hmojicag/public-glucometro-infrarrojo/SourceV0.3/BasicGlucoTester-CS-VisualStudioProject/BasicGlucoTester/Resources/gota.png

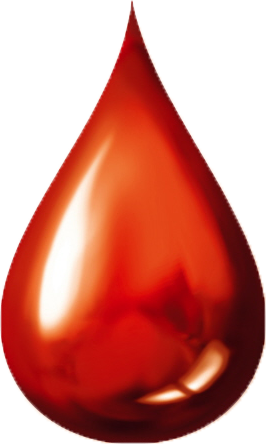
SourceV0.3/BasicGlucoTester-CS-VisualStudioProject/BasicGlucoTester/Resources/gota.png
