hmojicag/public-glucometro-infrarrojo/README.md

# public-glucometro-infrarrojo
Codigo, banners y documentos del glucometro infrarrojo
