hmojicag/public-glucometro-infrarrojo/Glucometro_Infrarrojo.pdf

## Glucometro Infrarrojo

Hazael F. Mojica G. y Ricardo I. Guevara Z.

Lunes 2 de Diciembre del 2013

Hazael Fernando Mojica Garcia Ricardo Israel Guevara Zavala Medidor de glucosa por Infrarrojos

## 1. INTRODUCCION´

Existen muchas personas en el mundo y en especial en Mexico con problemas para con- ´ trolar su nivel de glucosa en la sangre. Padecimientos tales como la diabetes afectan alrededor
de 10 millones de personas en tan solo en M ´ | exico y 13 de cada 100 muertes en este pa ´ | ´ıs son
a causa de la diabetes.
El proyecto que proponemos es una manera de detectar niveles anormales de glucosa en la sangre por medio de dispositivos sencillos, rapidos y eficientes tales como los sensores de ´ infrarrojo.
La glucosa muestra una alta absorbancia a la luz infrarroja, por lo tanto es posible desarro-
llar un dispositivo electronico que sea portatil, r ´ | apido, econ ´ | omico y fiable capaz de detectar ´
dicha absorbancia en una muestra de sangre, analizarla y arrojar la cantidad de glucosa con-tenida en la misma.
La glucosa existente en la sangre, como toda sustancia, posee niveles de absorbancia (cantidad de luz que dicha sustancia absorbe, la cual es transformada en otra forma de energ´ıa). La glucosa posee la particularidad de tener un gran valor de absorbancia para la luz infrarroja (940 nm de longitud de onda). Basandonos en dicho principio, nosotros hemos desarrollado ´ un dispositivo capaz de medir dicha absorbancia por medio de dispositivos electronicos de ´ uso comercial.
Por medio de un arreglo de leds que emiten en el infrarrojo, un arreglo de transistores capaz de detectar los fotones emitidos a la longitud de onda correcta (o mejor dicho, la varia-
cion de dicha intensidad) y una sistema de adquisici ´ | on de datos el cual utiliza un procesador ´
Arduino. Con base en dichos elementos y aunado a un software desarrollado exprofeso para esta aplicacion, hemos logrado crear un dispositivo capaz de detectar con nivel de exactitud ´ aceptable, la absorbancia de varias muestras que poseen una solucion con diferentes niveles ´ de glucosa diluidas en las mismas.
Como resultado, hemos desarrollado un sistema para analisis de glucosa de forma port ´ | atil, ´
eficiente y economica. ´
| 1

1.1 Espectro de Absorcion de la sangre | 1 INTRODUCCI ´ | ON´

### 1.1. Espectro de Absorcion de la sangre ´

La sangre y en especial la glucosa poseen espectros de absorcion con valores altos para ´ longitudes de onda que entran en el rango del infrarrojo. Esto beneficia a nuestra investigacion´ porque si la sangre a analizar absorbe mayor radiacion infrarroja quiere decir que tendremos ´
una mayor variacion por cada diferencia de concentraci ´ | on de glucosa en la sangre a analizar. ´

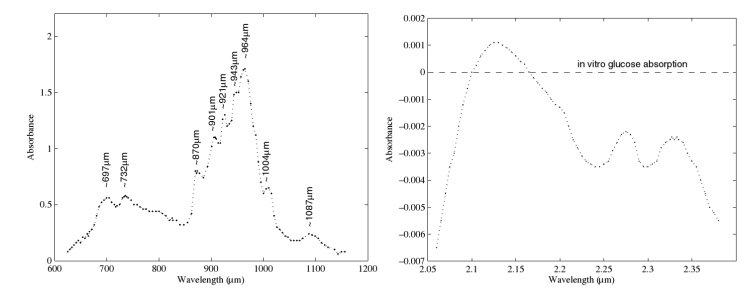
[picture p10: figure]

Figura 1 La imagen muestra el espectro de absrocion de la Glucosa. Esta imagen es propiedad ´ intelectual de Frederick Chee y Tyrone Fernando?

En la imagen Fig.?? podemos ver el espectro de absorcion de la glucosa y claramente ´ se observa que el espectro de absorcion para valores de longitudes de onda en rangos del ´ infrarrojo (en especial entre 900 y 1000 nm) poseen una Absorbancia muy elevada.

La medicion de la cantidad de glucosa en la sangre es una pr ´ | actica com ´ | un en la actua- ´
lidad, y en la mayor´ıa de los casos conocidos se necesita siempre una muestra de sangre a analizar, para los fines de este proyecto nosotros tambien analizaremos una muestra de sangre ´ pero en lugar de aplicar un voltaje y medir la corriente a traves de dicha muestra lo que hare- ´
mos sera irradiar dicha muestra con luz infrarroja (940nm de longitud de onda seg ´ | un nuestro ´
emisor LED IR333 Fig.?? y Fig.??) y recibiremos por medio de un receptor (foto transistor
IR PT1302B/C2 ) la senal atenuada despu ˜ | es de atravesar la muestra. ´

2

1 INTRODUCCION | 1.1 Espectro de Absorci ´ | on de la sangre ´

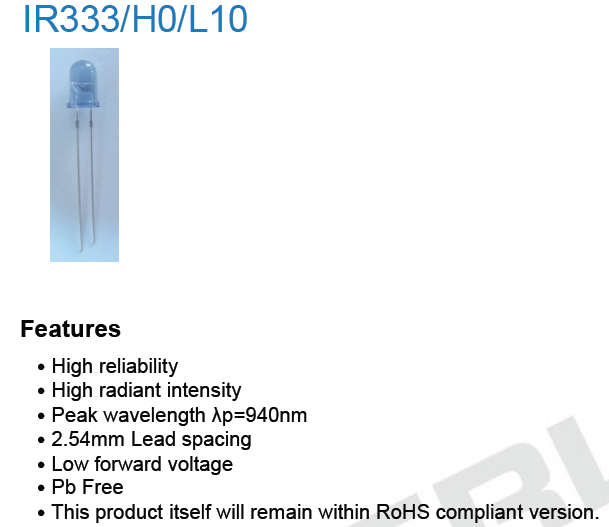
[picture p11: figure]

Figura 2 Caracter´ısticas principales del emisor IR usado

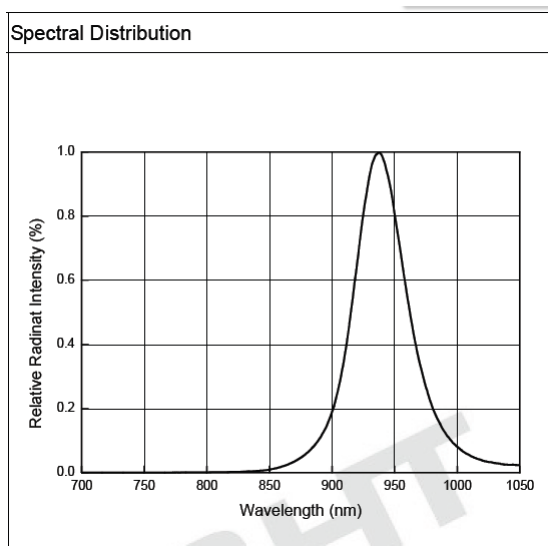
[picture p12: figure]

Figura 3 Curva de la Intensidad de Radiacion Relativa contra la longitud de onda. Se observa que las ´ emisiones de luz de 940nm son las mas intensas ´

La diferencia entre la senal emitida y la se ˜ | nal recibida ser ˜ | a medida y comparada en dife- ´
rentes muestras de sangre, y asi poder discernir entre las muestras que puedan ser consideradas con niveles de glucosa normales y aquellas que posean niveles de glucosa anormales.
| 3

2 ESQUEMATICOS DEL SISTEMA FINAL ´

Sin duda alguna no obtendremos un espectro completo de las longitudes de onda que absorbe la muestra de sangre ya que solo la irradiaremos con longitudes de onda pertene-cientes a los infrarrojos (en especial la de 940nm), pero realizaremos pruebas para saber si es suficiente con esta longitud de onda para obtener resultados concluyentes.
Se usara un Arduino para la obtenci ´ | on de los datos y posiblemente para el despliegue de ´
los resultados por medio de una pantalla LCD, este tendra tambi ´ | en conexi ´ | on a la computadora ´
por medio de USB (emulacion de puerto serie UART) para simplificar la calibraci ´ | on. ´
Se planea hacer una shield para Arduino en donde se puedan conectar todos los dispositivos.

## 2. Esquematicos del sistema final ´

Debido al bajo presupuesto se acordo que solo se dejaran dos tarjetas, las cuales son las ´ m´ınimas necesarias para que el proyecto funcione de la mejor manera posible.
La Tarjeta shield (en la cual se enbebio la tarjeta LCD y la Tarjeta de los push-buttons) y ´ la Tarjeta IR. (Se decidio no embeber la tarjeta IR dentro de la shield debido a los soportes ´ hechos en acr´ılico que sobrepasan el tamano del shield mismo). ˜

4

2 ESQUEMATICOS DEL SISTEMA FINAL2.1 Esquem ´ | aticos y Dise ´ | no electr ˜ | onico: Tarjeta Shield Final ´
2.1. Esquematicos y Dise ´ | no electr ˜ | onico: Tarjeta Shield Final ´

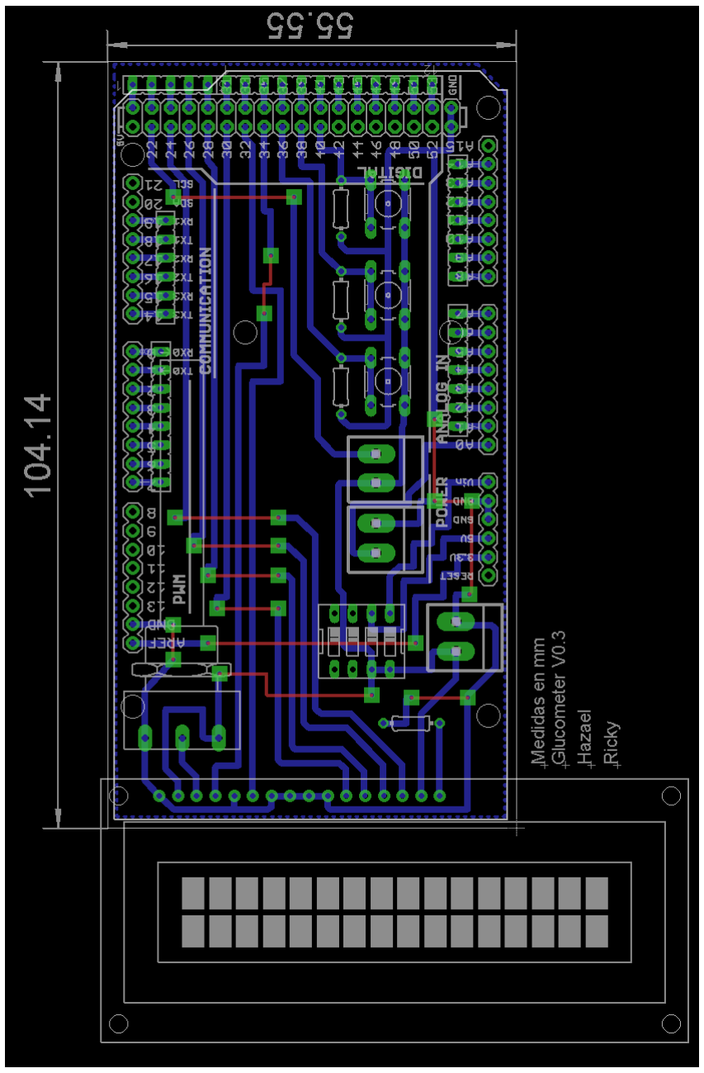
[picture p13: figure]

Figura 4 Diseno electr ˜ | onico de la tarjeta shield ´

5

2.1 Esquematicos y Dise ´ | no electr ˜ | onico: Tarjeta Shield Final2 ESQUEM ´ | ATICOS DEL SISTEMA FINAL ´

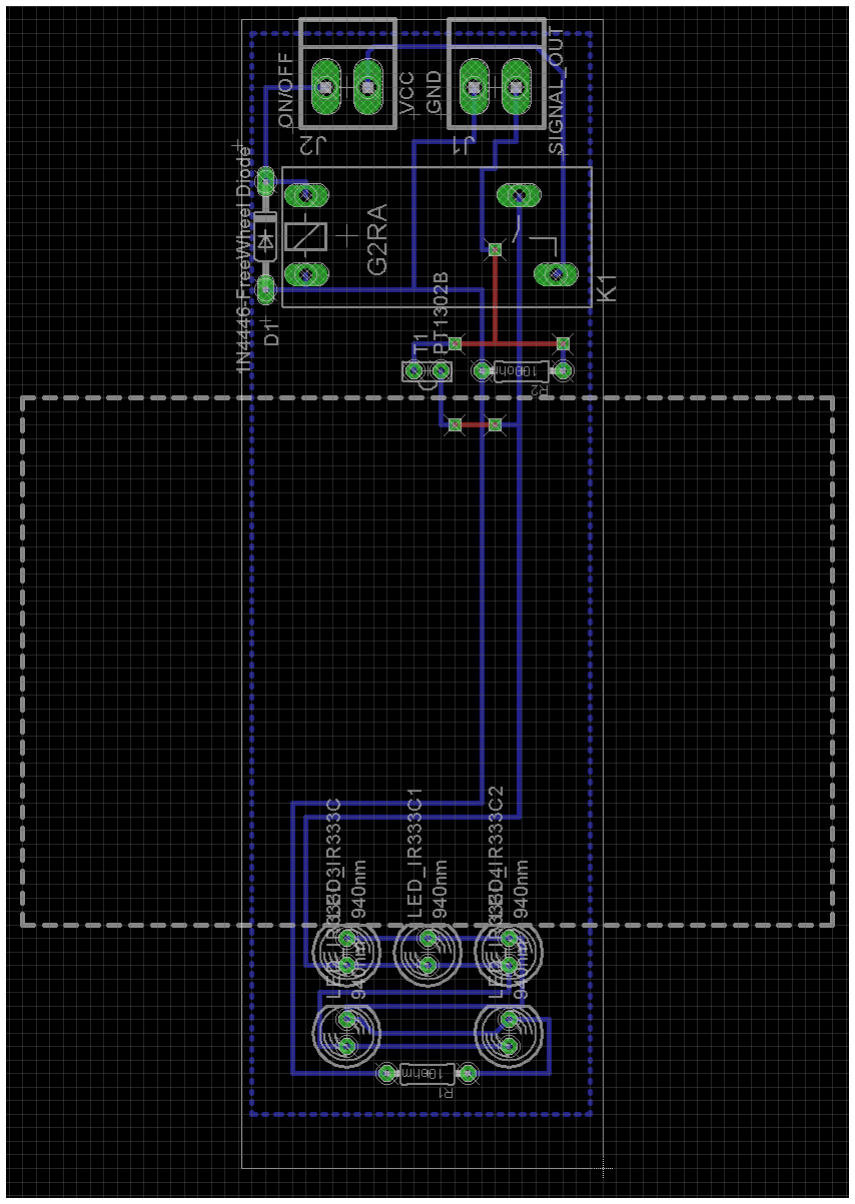
[picture p14: figure]

Figura 5 Diseno electr ˜ | onico de la tarjeta IR ´

6

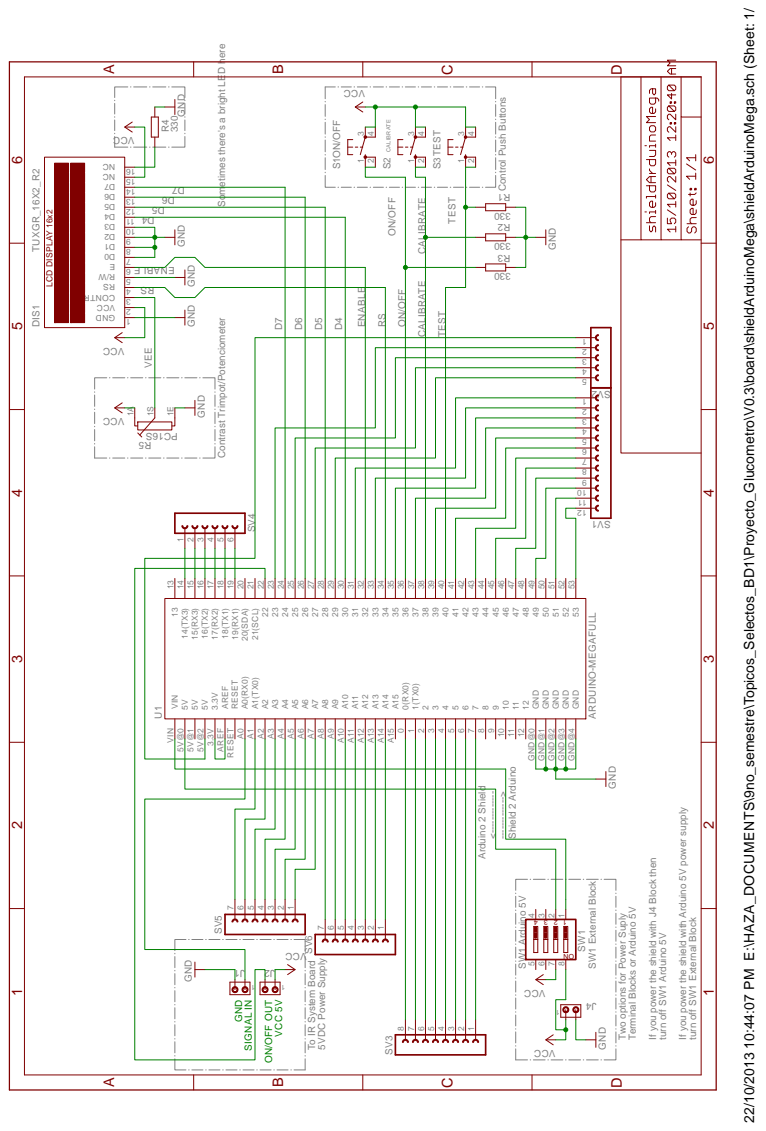
[picture p15: page 7]

22/10/2013 10:44:07 PM E:\HAZA_DOCUMENTS\9no_semestre\Topicos_Selectos_BD1\Proyecto_Glucometro\V0.3\board\shieldArduinoMega\shieldArduinoMega.sch (Sheet: 1/

Sometimes there's a bright LED here Contrast Trimpot/Potenciometer

If you power the shield with Arduino 5V power supply

If you power the shield with J4 Block then

Terminal Blocks or Arduino 5V

Two options for Power Suply

turn off SW1 External Block

To IR System Board

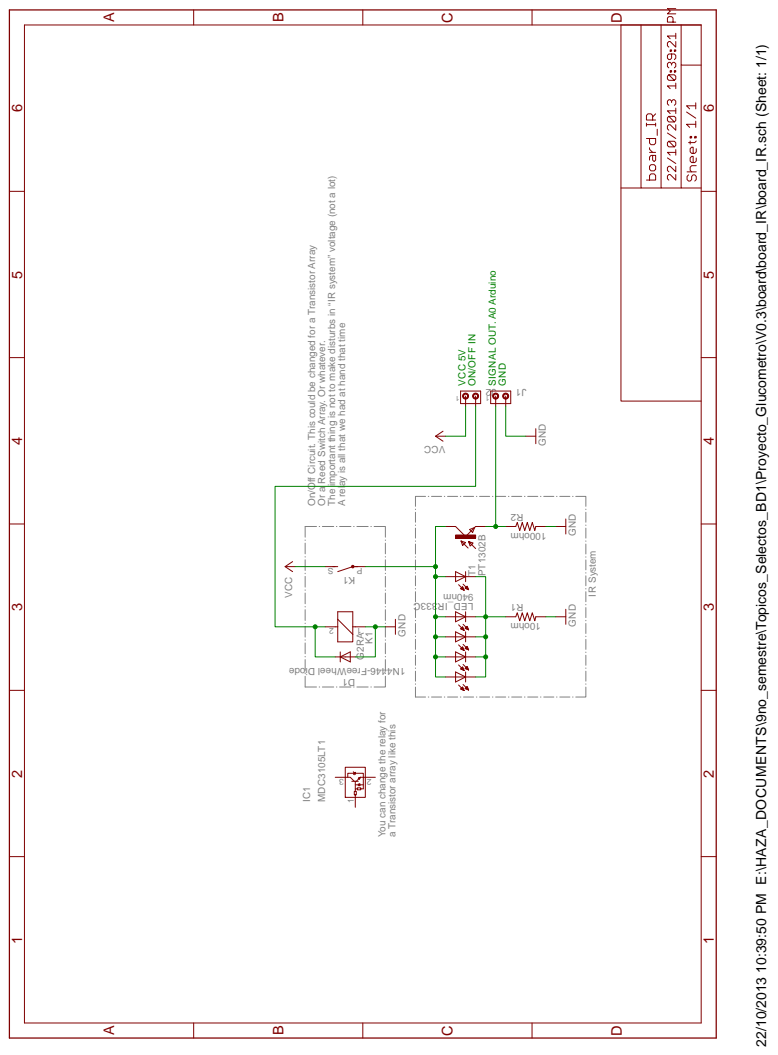
[picture p16: page 8]
IR System; GND; VCC; MDC3105LT1; VCC 5V

22/10/2013 10:39:50 PM E:\HAZA_DOCUMENTS\9no_semestre\Topicos_Selectos_BD1\Proyecto_Glucometro\V0.3\board\board_IR\board_IR.sch (Sheet: 1/1)

The important thing is not to make disturbs in “IR system” voltage (not a lot)

On/Off Circuit. This could be changed for a Transistor Array

SIGNAL OUT. A0 Arduino

A relay is all that we had at hand that time

ON/OFF IN

Or a Reed Switch Array. Or whatever.

You can change the relay for

a Transistor array like this

3 CONSTRUCCION DE LAS PCB ´

## 3. Construccion de las PCB ´

Construccion y dise ´ | no de la placa PCB ˜

9

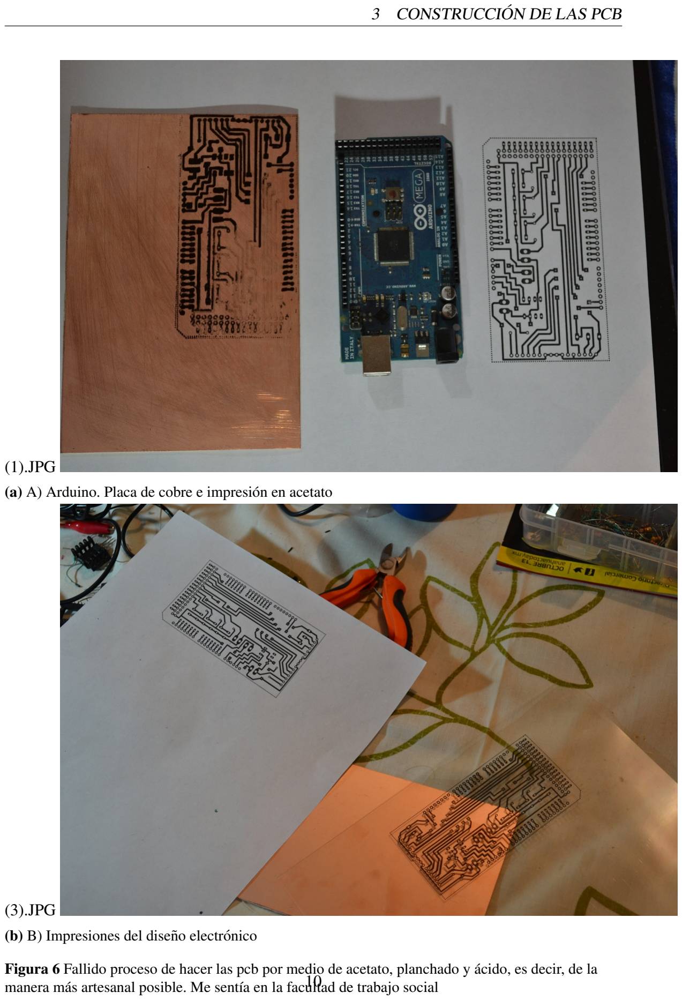
[picture p17: page 10]

3 CONSTRUCCION DE LAS PCB ´

(1).JPG

(a) A) Arduino. Placa de cobre e impresion en acetato ´

(3).JPG

(b) B) Impresiones del diseno electr ˜ | onico ´

Figura 6 Fallido proceso de hacer las pcb por medio de acetato, planchado y acido, es decir, de la ´
manera mas artesanal posible. Me sent ´ | ´ıa en la facultad de trabajo social 10

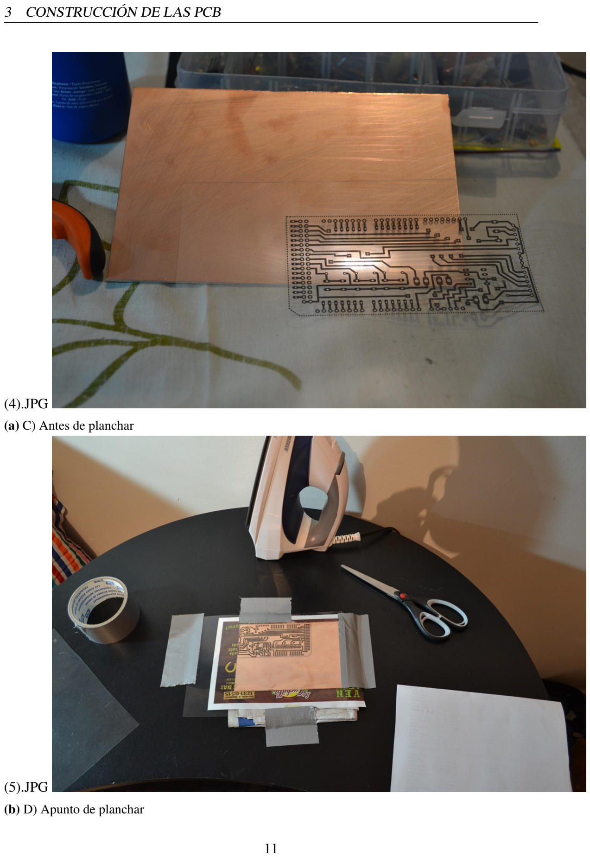
[picture p18: page 11]

3 CONSTRUCCION DE LAS PCB ´

(4).JPG

(a) C) Antes de planchar

(5).JPG

(b) D) Apunto de planchar

11

3 CONSTRUCCION DE LAS PCB ´

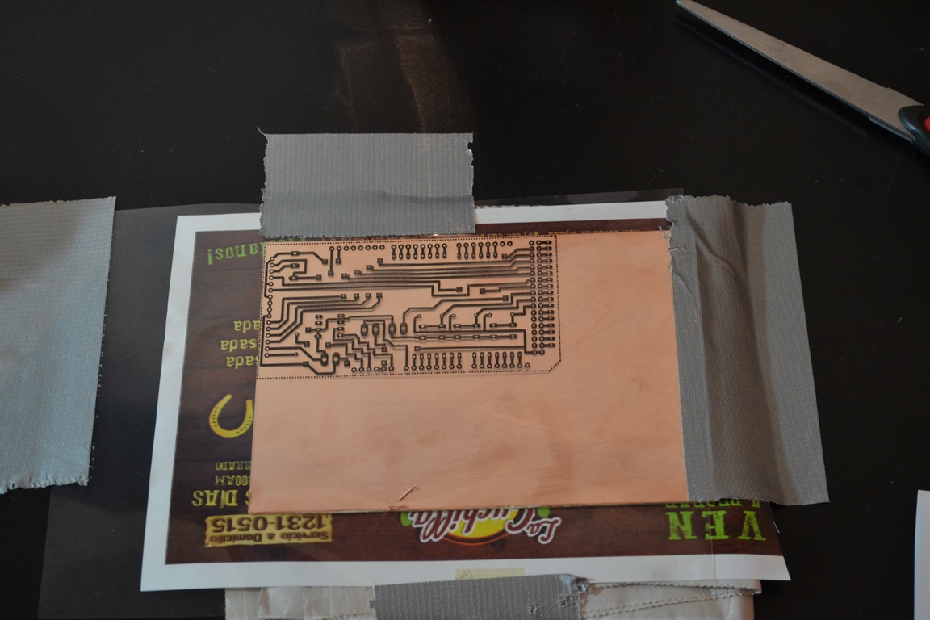
[picture p19: figure]

(6).JPG

(a) E) Planchado

12

4 PARTE MECANICA DEL PROYECTO ´

## 4. Parte mecanica del proyecto ´

La idea principal es crear un soporte o base donde poder colocar las muestras de sangre y que puedan ser irradiadas con los rayos infrarrojos por un extremo y por el otro el receptor capture dicha radiacion parcial (debido a la absorbancia de la muestra de sangre). ´
Se ha propuesto crear una base hecha de material acr´ılico de 4mm de espesor con una ranura en la que pueda colocarse de manera vertical la muestra de sangre.
Esta base estara unida a la placa electr ´ | onica ”Tarjeta IR”. ´

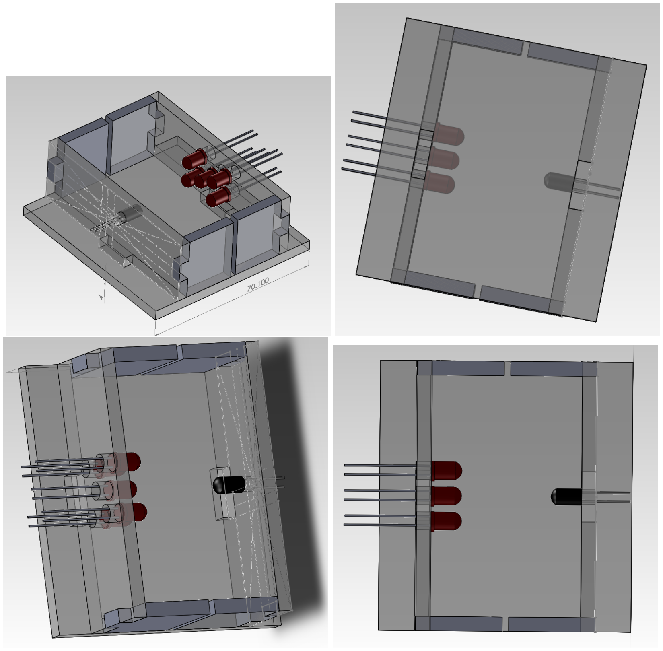
[picture p20: figure]

Figura 9 Vista del soporte mecanico de la Tarjeta IR ´

13

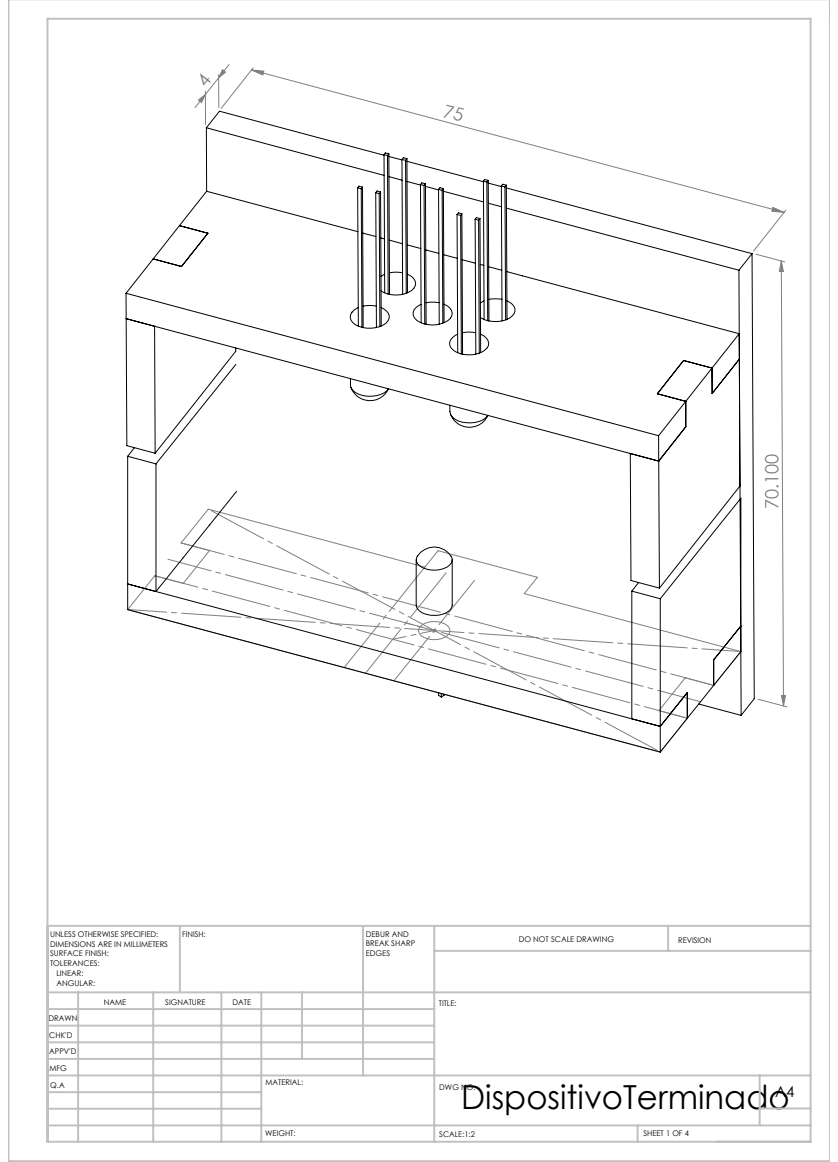
[picture p21: page 14]
SCALE:1:2; SHEET 1 OF 4; DO NOT SCALE DRAWING; REVISION; DEBUR AND BREAK SHARP EDGES; UNLESS OTHERWISE SPECIFIED:; FINISH:

DIMENSIONS ARE IN MILLIMETERS
SURFACE FINISH:
TOLERANCES:
LINEAR:
ANGULAR:

NAME | SIGNATURE | DATE | | | | TITLE:
Q.A | | | | MATERIAL: | DispositivoTerminado WEIGHT: DWG NO. | A4

DRAWN
CHK'D
APPV'D
MFG

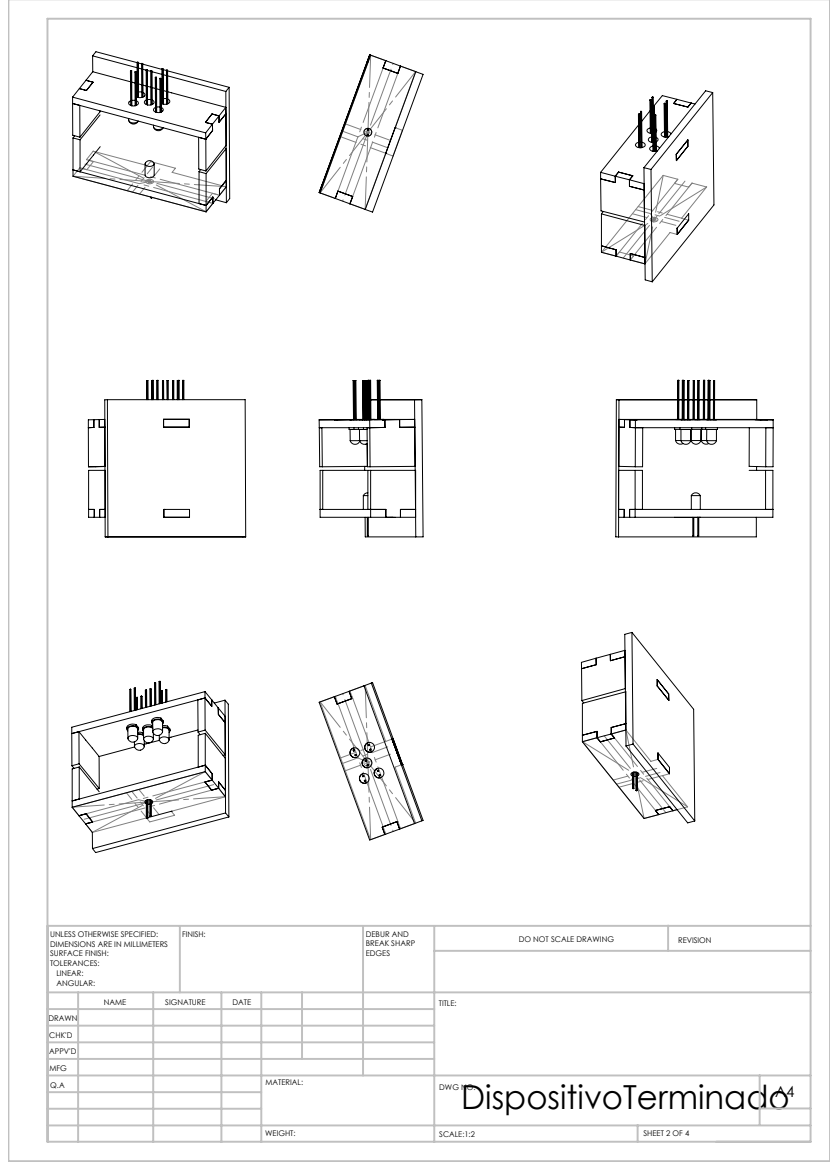
[picture p22: page 15]
SCALE:1:2; SHEET 2 OF 4; DO NOT SCALE DRAWING; REVISION; DEBUR AND BREAK SHARP EDGES; UNLESS OTHERWISE SPECIFIED:; FINISH:

DIMENSIONS ARE IN MILLIMETERS
SURFACE FINISH:
TOLERANCES:
LINEAR:
ANGULAR:

NAME | SIGNATURE | DATE | | | | TITLE:
Q.A | | | | MATERIAL: | DispositivoTerminado WEIGHT: DWG NO. | A4

DRAWN
CHK'D
APPV'D
MFG

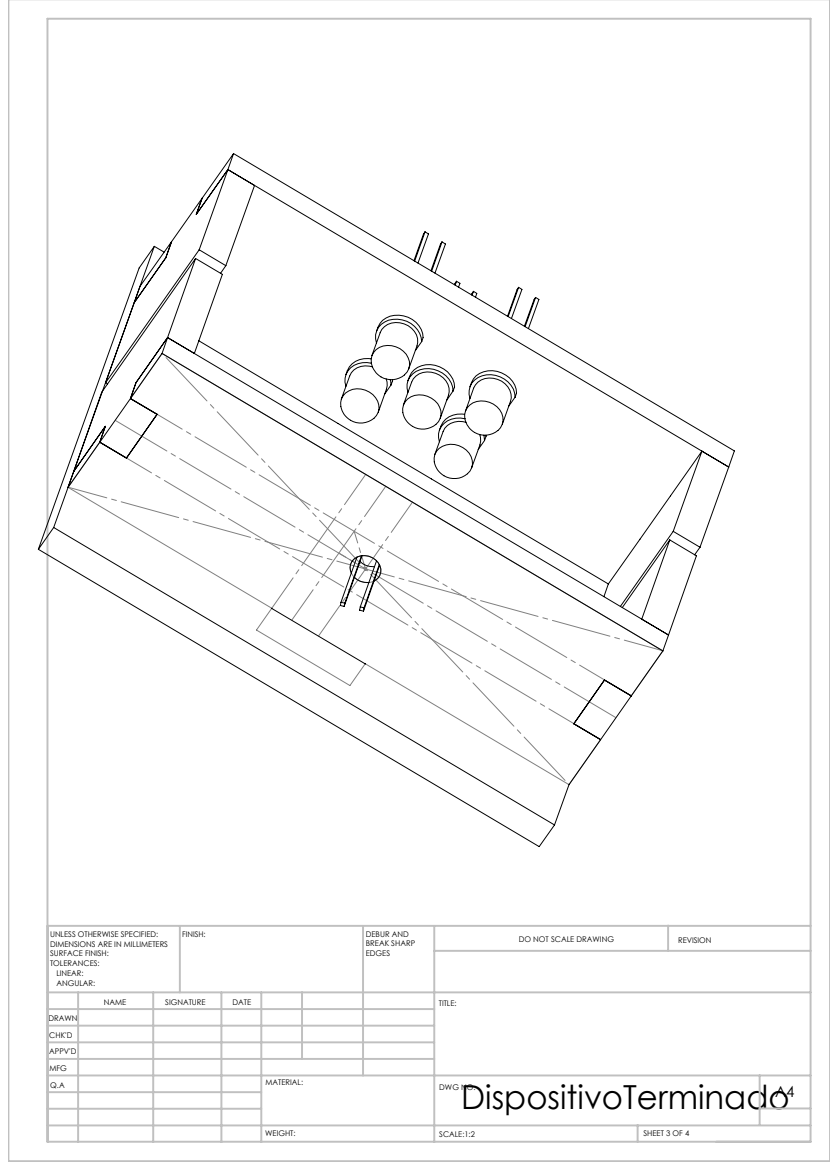
[picture p23: page 16]
SCALE:1:2; SHEET 3 OF 4; DO NOT SCALE DRAWING; REVISION; DEBUR AND BREAK SHARP EDGES; UNLESS OTHERWISE SPECIFIED:; FINISH:

DIMENSIONS ARE IN MILLIMETERS
SURFACE FINISH:
TOLERANCES:
LINEAR:
ANGULAR:

NAME | SIGNATURE | DATE | | | | TITLE:
Q.A | | | | MATERIAL: | DispositivoTerminado WEIGHT: DWG NO. | A4

DRAWN
CHK'D
APPV'D
MFG

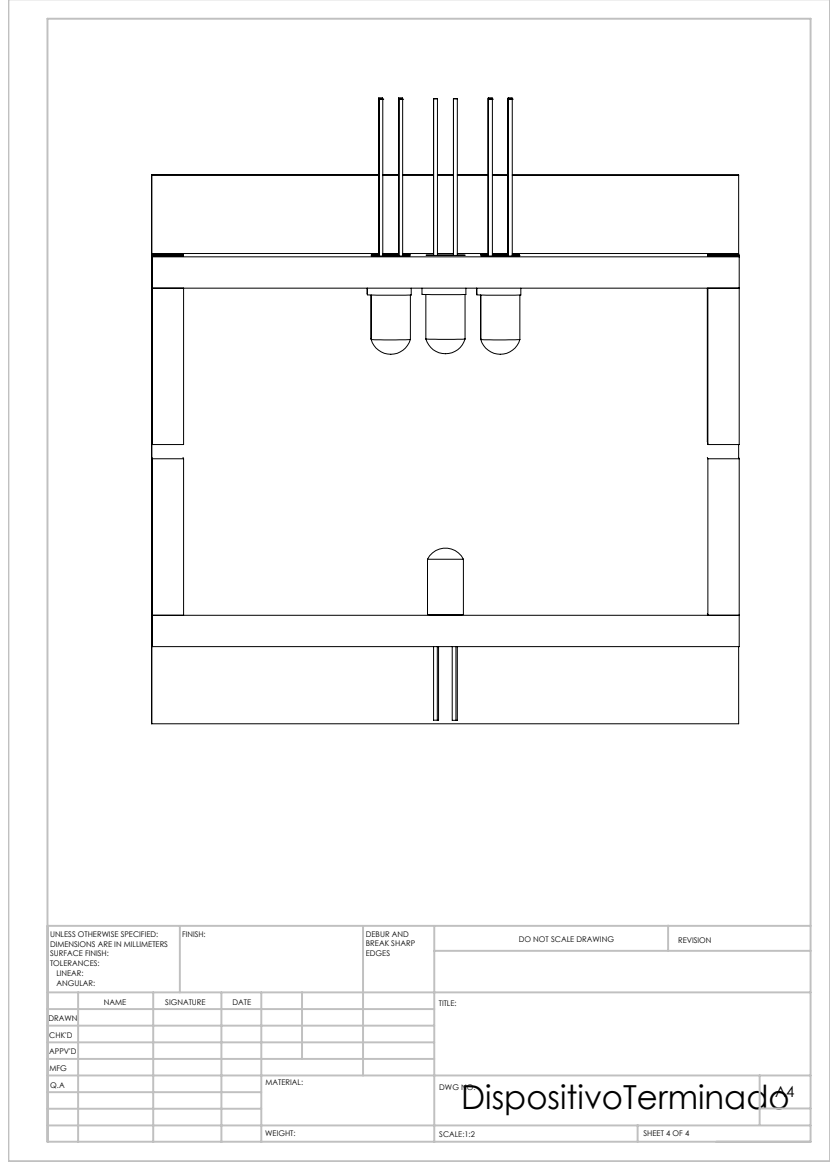
[picture p24: page 17]
SCALE:1:2; SHEET 4 OF 4; DO NOT SCALE DRAWING; REVISION; DEBUR AND BREAK SHARP EDGES; UNLESS OTHERWISE SPECIFIED:; FINISH:

DIMENSIONS ARE IN MILLIMETERS
SURFACE FINISH:
TOLERANCES:
LINEAR:
ANGULAR:

NAME | SIGNATURE | DATE | | | | TITLE:
Q.A | | | | MATERIAL: | DispositivoTerminado WEIGHT: DWG NO. | A4

DRAWN
CHK'D
APPV'D
MFG

4.1 Diseno Final | 4 PARTE MEC ˜ | ANICA DEL PROYECTO ´

### 4.1. Diseno Final ˜

La tarjeta Shield final hecha con ProtoShield.

18

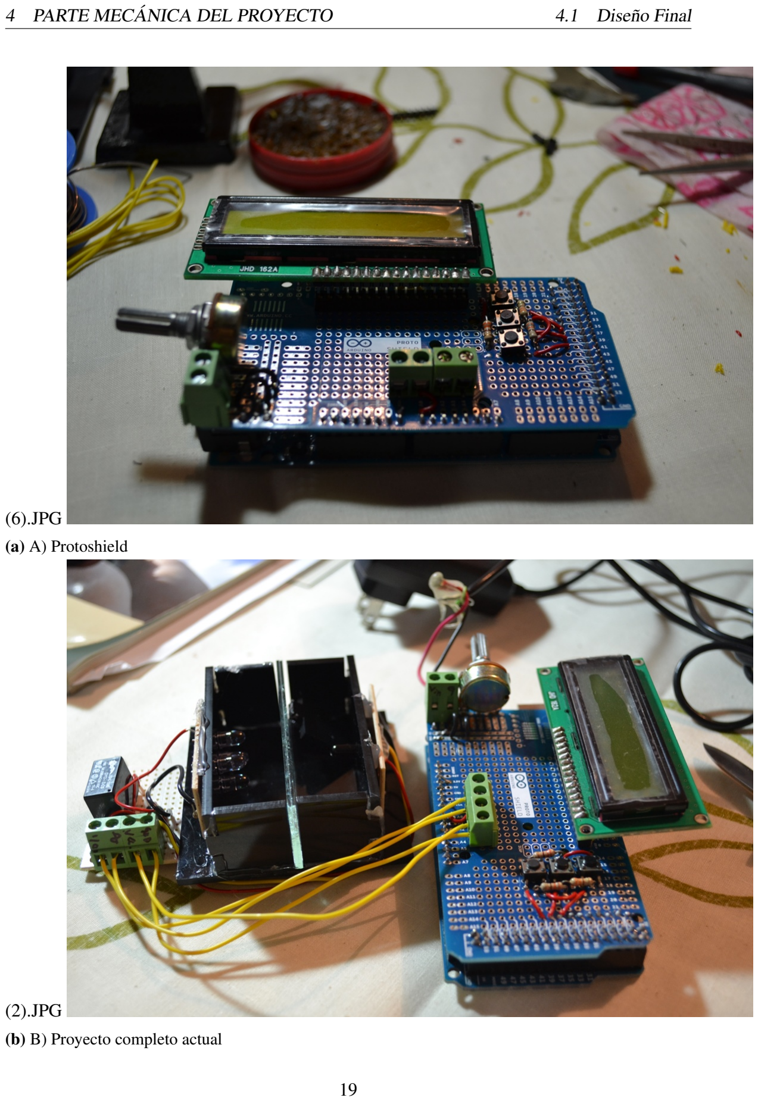
[picture p25: page 19]

4 PARTE MECANICA DEL PROYECTO | 4.1 Dise ´ | no Final ˜

(6).JPG

(a) A) Protoshield

(2).JPG

(b) B) Proyecto completo actual

19

5 DESARROLLO DE SOFTWARE

## 5. Desarrollo de software

Se ha creado un software para el proposito de medir la Absorbancia de las muestras de ´ sangre. Este esta programado en .Net en el lenguaje C sharp para la plataforma de Windows, ´ bien pudiendo ser emulado con Mono (MonoDevelop Proyect ?
) para diversas plataforma (Linux, Mac).

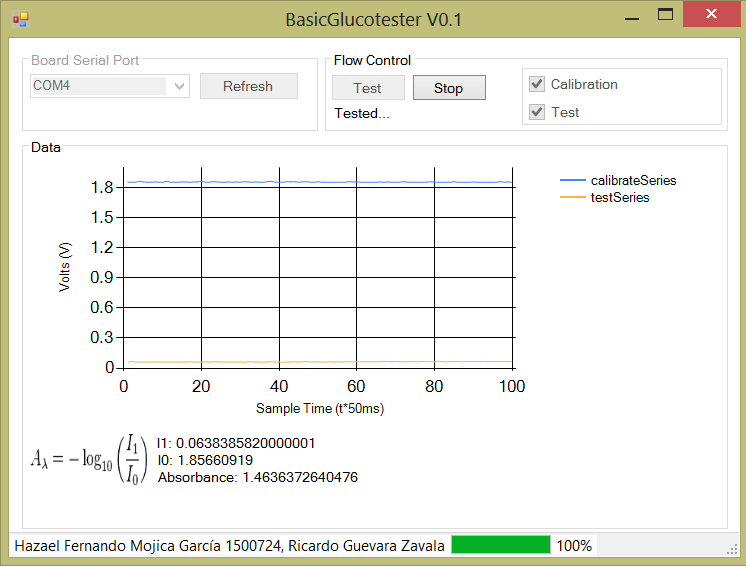
[picture p26: figure]

Figura 11 Software desarrollado a la medida para este proyecto en C Sharp

Este software posee conexion con el Arduino, lo que este software realiza es b ´ | asicamente ´
es tomar lecturas del ADC del arduino en el cual se encuentra conectado el receptor IR dos veces, una antes de colocar la muestra (para calibrar, ser´ıa nuestra I0) y otra con la muestra colocada (ser´ıa la I1).
Procedimiento de uso:
1. Conectar Arduino a a PC (creacion de puerto serie virtual) ´
2. Iniciar software
3. En el software click en “Calibrate”
a) Tomara 100 valores del ADC, uno cada 10ms (usando un Timer) ´
b) Los promediara para obtener la ´ | I0
4. Colocar la muestra de sangre en el aparato
5. En el software click en “Test”
| 20

6 FIRMWARE PARA ARDUINO

a) Tomara 100 valores del ADC, uno cada 10ms (usando un Timer) ´
b) Los promediara para obtener la ´ | I1
6. El software calculara A (absorbancia) ´

## 6. Firmware para Arduino

El firmware cargado en el Arduino practicamente lo ´ | unico que hace es esperar a que la PC ´
por medio de comunicacion Serie le pida un valor obtenido del ADC, en lo que espera este ´ se encuentra constantemente haciendo la conversion anal ´ ogica a digital para tener siempre un ´ valor listo a entregar.
En la comunicacion influyen 3 etapas importantes: ´

Inicializacion: La PC debe enviar una cadena de caracteres para poder iniciar la comu- ´ nicacion´

Pedido de datos: La PC enviado un caracter de control espec ´ | ´ıfico le pide al Arduino le
env´ıe un valor del ADC
Fin de la comunicacion: La PC enviando un car ´ | acter de control espec ´ | ´ıfico termina la
comunicacion y coloca al Arduino en un estado de “espera de inicializaci ´ | | on”. ´

El ADC posee una referencia a 3.3V y es capaz de muestrear en 10bits, eso hace una resolucion de 0.00322V (3.22mV) detectables. En otras palabras cuando el ADC arroje 0 ´
seran 0V, cuando arroje 1 ser ´ | an 3.22mV y cuando arroje 1023 ser ´ | an 3.3V. ´

21
