hmojicag/public-glucometro-infrarrojo/SourceV0.3/Eagle-Board-Schematics/board_IR/BOARD_ir.png

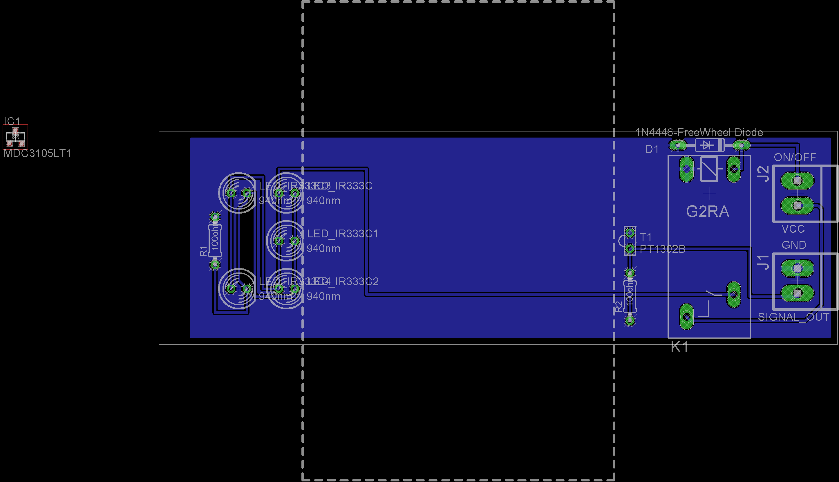
SourceV0.3/Eagle-Board-Schematics/board_IR/BOARD_ir.png
