hmojicag/public-glucometro-infrarrojo/SourceV0.3/Eagle-Board-Schematics/BOM.xlsx

BILL OF MATERIALS
Cantidad | No.Parte | Descripción | Link | Precio | SUBTOTAL MIN
4 | TRTG-02 | Terminal grande con 2 tornillos, para circuito impreso | http://www.steren.com.mx/catalogo/prod.asp?f=&sf=81&c=767&p=3536 | 6 | 24
2 | DIP-4P | Switch deslizable (Dip Switch) de 4 posiciones | http://www.steren.com.mx/catalogo/prod.asp?f=&sf=89&c=821&p=1612 | 4.306 | 8.612
4 | AU-101 | Micro switch, de push, con 4 terminales | http://www.steren.com.mx/catalogo/prod.asp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 | 3 | 12
1 | F36-D | Tira de 36 pines doble | http://www.steren.com.mx/catalogo/prod.asp?f=&sf=&c=&p=1779&desc=tira-de-36-pines-doble-&result=header | 8 | 8
1 | PC-10X15 | Placa fenólica una cara, de 10 x 15 cm | http://www.steren.com.mx/catalogo/prod.asp?f=&sf=115&c=1044&p=2517 | 17 | 17
TOTAL S/IVA |  |  |  |  | 69.612
IVA |  |  |  |  | 10.4418
TOTAL |  |  |  |  | 80.0538
