hmojicag/public-glucometro-infrarrojo/SourceV0.3/Eagle-Board-Schematics/BOMV3.xlsx

BILL OF MATERIALS
Cantidad | No.Parte | Descripción | Link | Precio | SUBTOTAL MIN
4 | TRTG-02 | Terminal grande con 2 tornillos, para circuito impreso | http://www.steren.com.mx/catalogo/prod.asp?f=&sf=81&c=767&p=3536 | 6 | 24
2 | DIP-4P | Switch deslizable (Dip Switch) de 4 posiciones | http://www.steren.com.mx/catalogo/prod.asp?f=&sf=89&c=821&p=1612 | 4.306 | 8.612
4 | AU-101 | Micro switch, de push, con 4 terminales | http://www.steren.com.mx/catalogo/prod.asp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 | 3 | 12
1 | F36-D | Tira de 36 pines doble | http://www.steren.com.mx/catalogo/prod.asp?f=&sf=&c=&p=1779&desc=tira-de-36-pines-doble-&result=header | 8 | 8
1 | PC-10X15 | Placa fenólica una cara, de 10 x 15 cm | http://www.steren.com.mx/catalogo/prod.asp?f=&sf=115&c=1044&p=2517 | 17 | 17
1 | MC025 | Cloruro férrico para grabado de circuito impreso, de 220 ml | http://www.steren.com.mx/catalogo/prod.asp?f=&sf=117&c=1053&p=2221 | 26 | 26
1 | 155 | Placa fenólica de 4,5 x 4,5 cm para proyectos | http://www.steren.com.mx/catalogo/prod.asp?f=&sf=115&c=1046&p=111 | 8 | 8
1 | 405 | Placa fenólica de 7,5 x 4,5 cm para proyectos | http://www.steren.com.mx/catalogo/category.asp?f=9&sf=115&c=1046 | 12 | 12
2 | IR383 | LED infrarrojo de 5 mm, larga distancia | http://www.steren.com.mx/catalogo/prod.asp?f=&sf=&c=&p=2059&resul=infrarrojo | 5 | 10
TOTAL S/IVA |  |  |  |  | 125.612
IVA |  |  |  |  | 18.8418
TOTAL |  |  |  |  | 144.4538
1 | A000080 | ARDUINO SHIELD - MEGA PROTO PCB REV3 | http://www.agspecinfo.com/pdfs/A/A000080.PDF | 86 | 86
1 | PRT-11417 | ARDUINO STACKABLE HEADER KIT-R3 SPARKFUN | http://www.agspecinfo.com/pdfs/P/PRT11417.PDF | 24.137 | 24.137
TOTAL S/IVA |  |  |  |  | 110.137
IVA |  |  |  |  | 16.52055
TOTAL |  |  |  |  | 126.65755
