hmojicag/public-glucometro-infrarrojo/SourceV0.3/SolidWorks-Frame-MechanicDesign-Project/Dispositivo.SLDASM

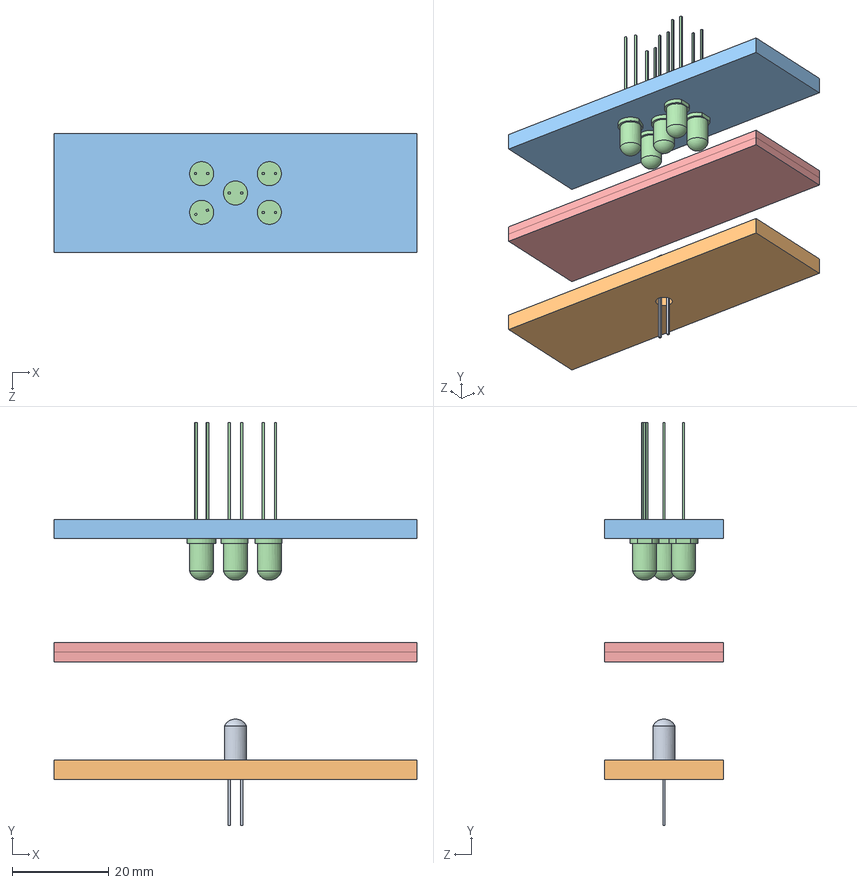
[picture p28: CAD file, 2019-03-25]
SourceV0.3/SolidWorks-Frame-MechanicDesign-Project/Dispositivo.SLDASM
75.0 x 83.3 x 24.5 mm
IRLed
Placa Base Infrarojo
Placa Base Led
Led x 5
Vidrio x 2
