hmojicag/public-glucometro-infrarrojo/SourceV0.3/SolidWorks-Frame-MechanicDesign-Project/DispositivoTerminado.SLDASM

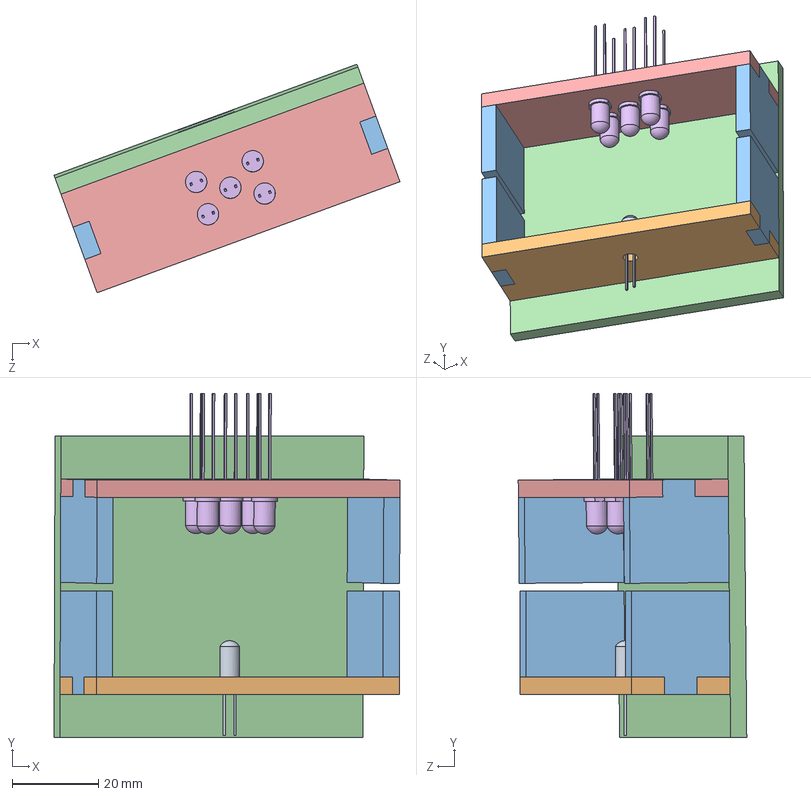
[picture p29: CAD file, 2019-03-25]
SourceV0.3/SolidWorks-Frame-MechanicDesign-Project/DispositivoTerminado.SLDASM
80.4 x 80.0 x 53.1 mm
IRLed
Placa Base Infrarojo 2
Pared x 4
BASE
Placa Base Led 2
Led x 5
