hmojicag/public-glucometro-infrarrojo/SourceV0.3/SolidWorks-Frame-MechanicDesign-Project/Placa Con IR.SLDASM

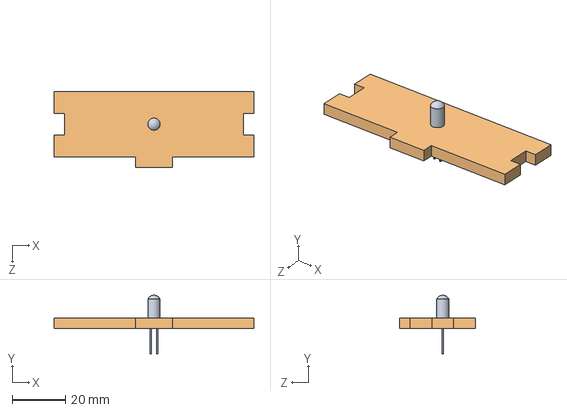
[picture p30: CAD file, 2019-03-25]
SourceV0.3/SolidWorks-Frame-MechanicDesign-Project/Placa Con IR.SLDASM
75.0 x 22.0 x 28.5 mm
IRLed
Placa Base Infrarojo 2
