hmojicag/public-glucometro-infrarrojo/SourceV0.3/SolidWorks-Frame-MechanicDesign-Project/Placa Con Leds.SLDASM

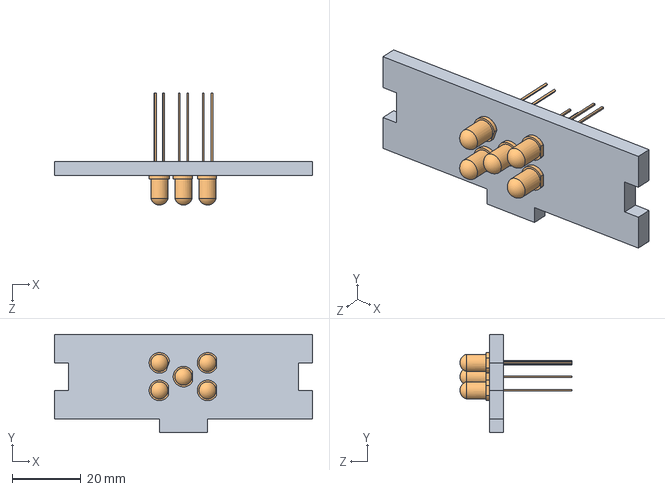
[picture p31: CAD file, 2019-03-25]
SourceV0.3/SolidWorks-Frame-MechanicDesign-Project/Placa Con Leds.SLDASM
75.0 x 28.5 x 32.6 mm
Placa Base Led 2
Led x 5
