hmojicag/public-glucometro-infrarrojo/SourceV0.3/SolidWorks-Frame-MechanicDesign-Project/Ensamblaje6.SLDASM

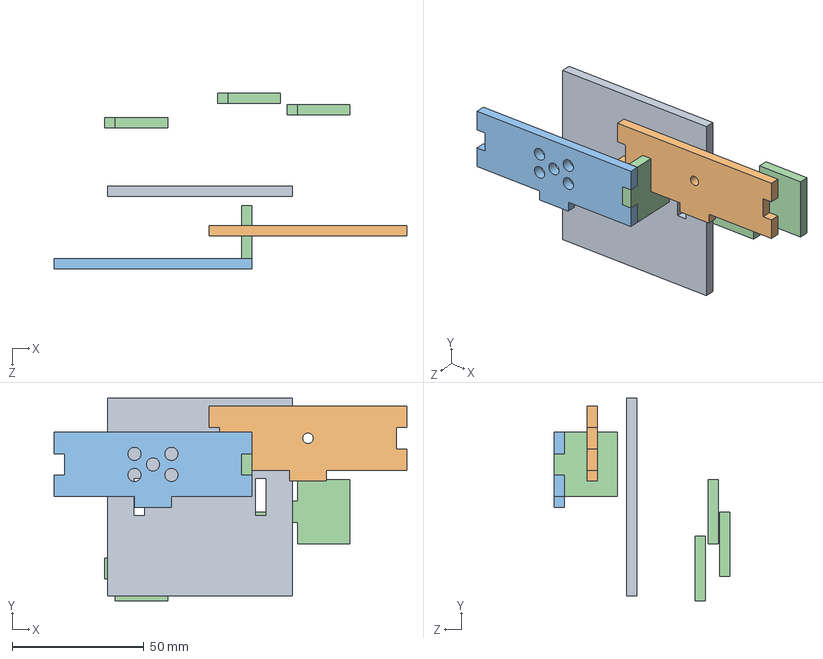
[picture p32: CAD file, 2019-03-25]
SourceV0.3/SolidWorks-Frame-MechanicDesign-Project/Ensamblaje6.SLDASM
133.7 x 76.8 x 66.6 mm
BASE
Placa Base Infrarojo 2
Placa Base Led 2
Pared x 4
