hmojicag/public-glucometro-infrarrojo/SourceV0.3/SolidWorks-Frame-MechanicDesign-Project/BaseConIRPared.SLDASM

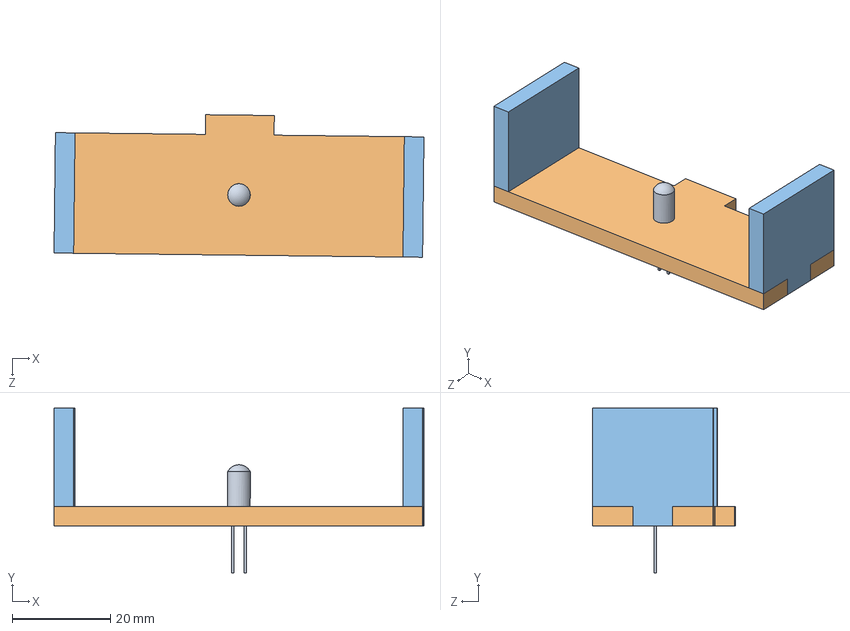
[picture p33: CAD file, 2019-03-25]
SourceV0.3/SolidWorks-Frame-MechanicDesign-Project/BaseConIRPared.SLDASM
75.3 x 33.5 x 29.0 mm
IRLed
Placa Base Infrarojo 2
Pared x 2
