hmojicag/public-glucometro-infrarrojo/SourceV0.3/SolidWorks-Frame-MechanicDesign-Project/Placa Base Led.SLDPRT

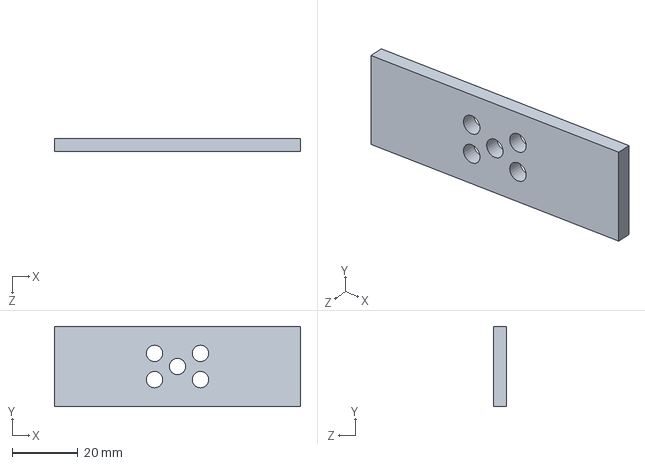
[picture p34: CAD file, 2019-03-25]
SourceV0.3/SolidWorks-Frame-MechanicDesign-Project/Placa Base Led.SLDPRT
75.0 x 24.5 x 4.00 mm
