hmojicag/public-glucometro-infrarrojo/SourceV0.3/SolidWorks-Frame-MechanicDesign-Project/Placa Base Infrarojo.SLDPRT

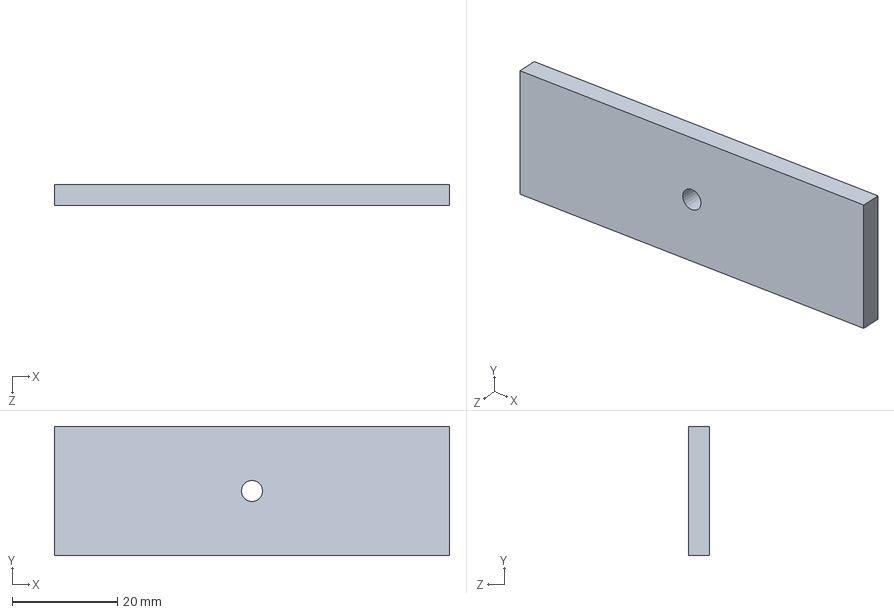
[picture p35: CAD file, 2019-03-25]
SourceV0.3/SolidWorks-Frame-MechanicDesign-Project/Placa Base Infrarojo.SLDPRT
75.0 x 24.5 x 4.00 mm
