hmojicag/public-glucometro-infrarrojo/SourceV0.3/SolidWorks-Frame-MechanicDesign-Project/Vidrio.SLDPRT

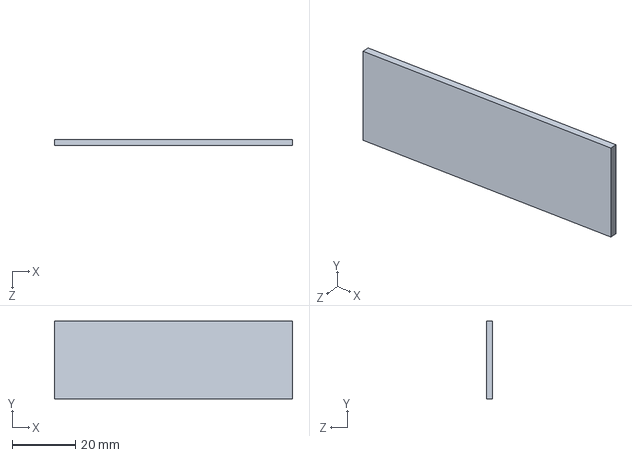
[picture p36: CAD file, 2019-03-25]
SourceV0.3/SolidWorks-Frame-MechanicDesign-Project/Vidrio.SLDPRT
75.0 x 24.5 x 2.00 mm
