hmojicag/public-glucometro-infrarrojo/SourceV0.3/SolidWorks-Frame-MechanicDesign-Project/Placa Base Infrarojo 2.SLDPRT

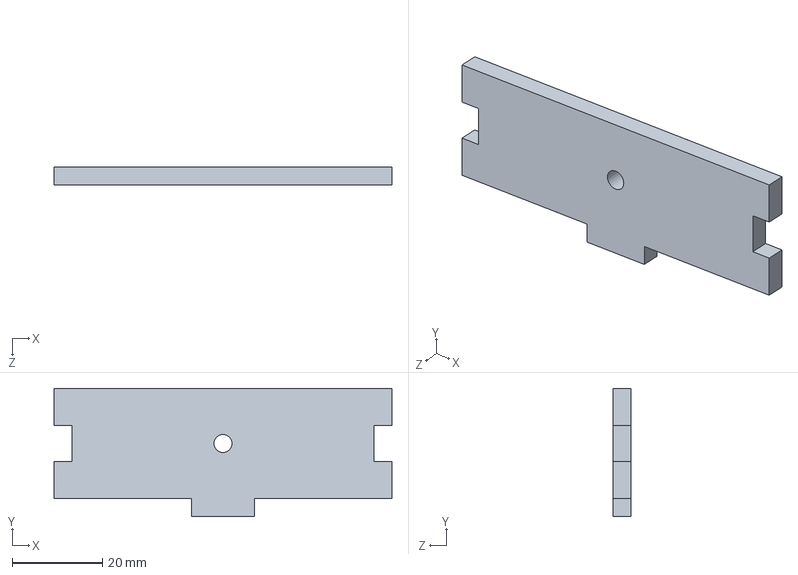
[picture p37: CAD file, 2019-03-25]
SourceV0.3/SolidWorks-Frame-MechanicDesign-Project/Placa Base Infrarojo 2.SLDPRT
75.0 x 28.5 x 4.00 mm
