hmojicag/public-glucometro-infrarrojo/SourceV0.3/SolidWorks-Frame-MechanicDesign-Project/Pared.SLDPRT

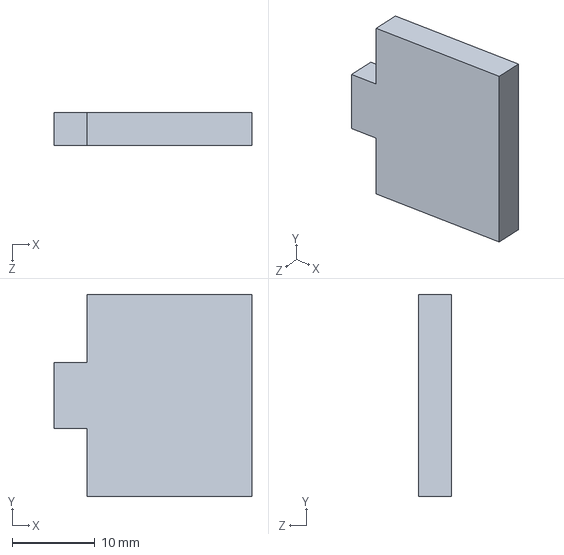
[picture p38: CAD file, 2019-03-25]
SourceV0.3/SolidWorks-Frame-MechanicDesign-Project/Pared.SLDPRT
24.0 x 24.5 x 4.00 mm
