hmojicag/public-glucometro-infrarrojo/SourceV0.3/SolidWorks-Frame-MechanicDesign-Project/Led.SLDPRT

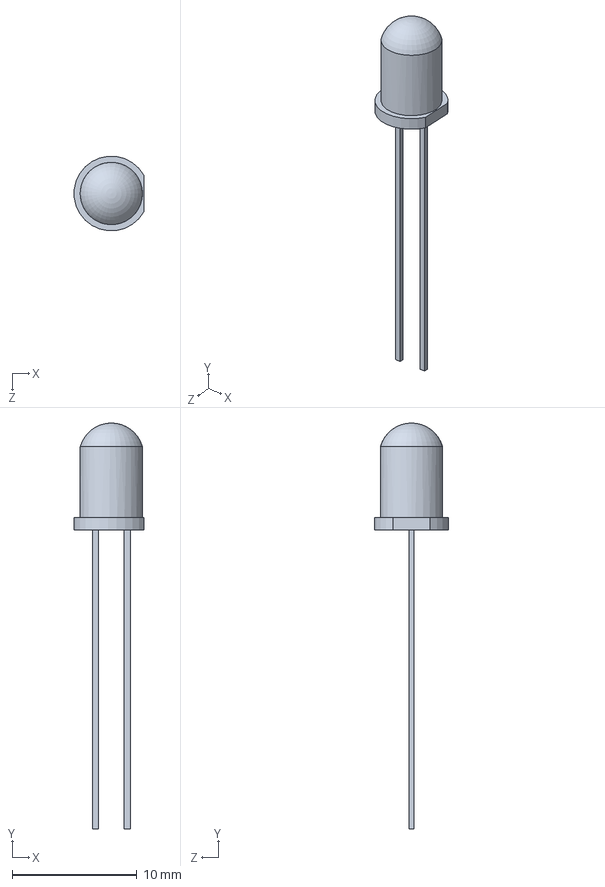
[picture p39: CAD file, 2019-03-25]
SourceV0.3/SolidWorks-Frame-MechanicDesign-Project/Led.SLDPRT
5.59 x 32.6 x 5.98 mm
