hmojicag/public-glucometro-infrarrojo/SourceV0.3/SolidWorks-Frame-MechanicDesign-Project/BASE.SLDPRT

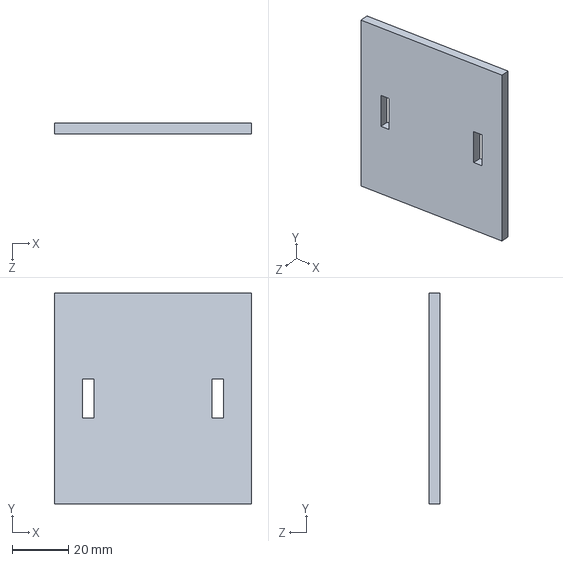
[picture p41: CAD file, 2019-03-25]
SourceV0.3/SolidWorks-Frame-MechanicDesign-Project/BASE.SLDPRT
70.1 x 75.0 x 4.00 mm
