hmojicag/public-glucometro-infrarrojo/SourceV0.3/SolidWorks-Frame-MechanicDesign-Project/IRLed.SLDPRT

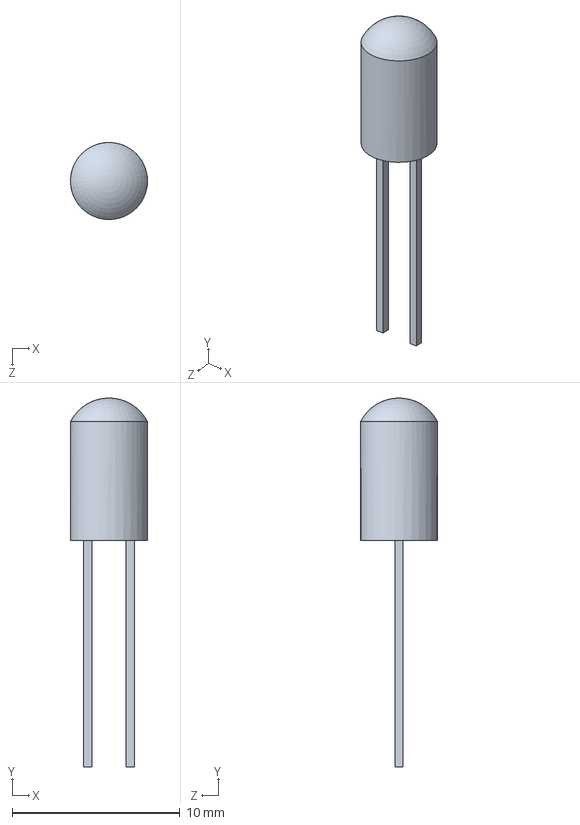
[picture p42: CAD file, 2019-03-25]
SourceV0.3/SolidWorks-Frame-MechanicDesign-Project/IRLed.SLDPRT
4.60 x 22.0 x 4.60 mm
