hmojicag/public-glucometro-infrarrojo/(list of files, cad)

Other CAD files:
SourceV0.3/SolidWorks-Frame-MechanicDesign-Project/BaseConLEDs.SLDASM
SourceV0.3/SolidWorks-Frame-MechanicDesign-Project/DispositivoTerminado.SLDDRW
