hmojicag/public-glucometro-infrarrojo/SourceV0.3/Eagle-Board-Schematics/board_IR/Plan_de_Implantacion.pdf

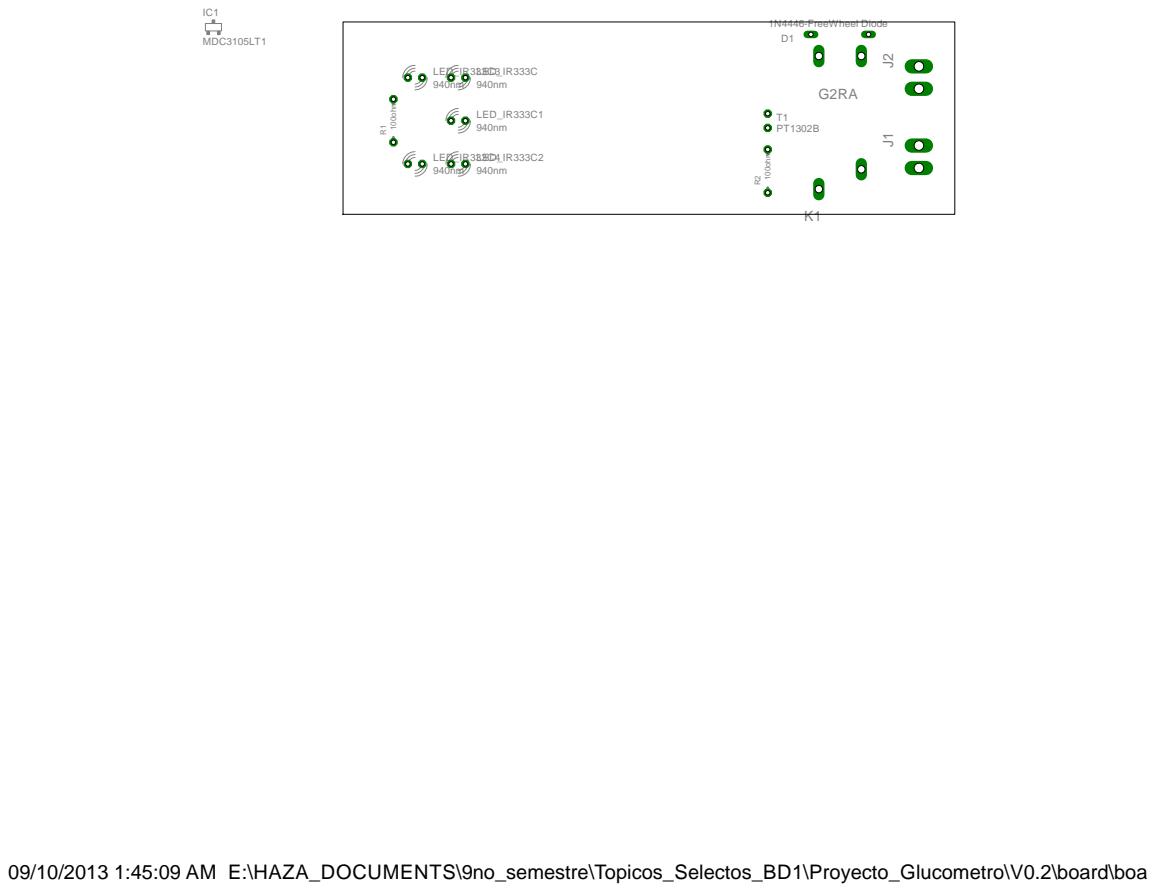
[picture p48: page 1]
LED_IR333C; LED_IR333C1; LED_IR333C2; LED_IR333C3; LED_IR333C4; 100ohm; 100ohm PT1302B; MDC3105LT1; 1N4446-FreeWheel Diode

09/10/2013 1:45:09 AM E:\HAZA_DOCUMENTS\9no_semestre\Topicos_Selectos_BD1\Proyecto_Glucometro\V0.2\board\boa R¹
