hmojicag/public-glucometro-infrarrojo/SourceV0.3/Eagle-Board-Schematics/board_IR/board_IR.brd

## EAGLE design SourceV0.3/Eagle-Board-Schematics/board_IR/board_IR.brd (2019-03-25)

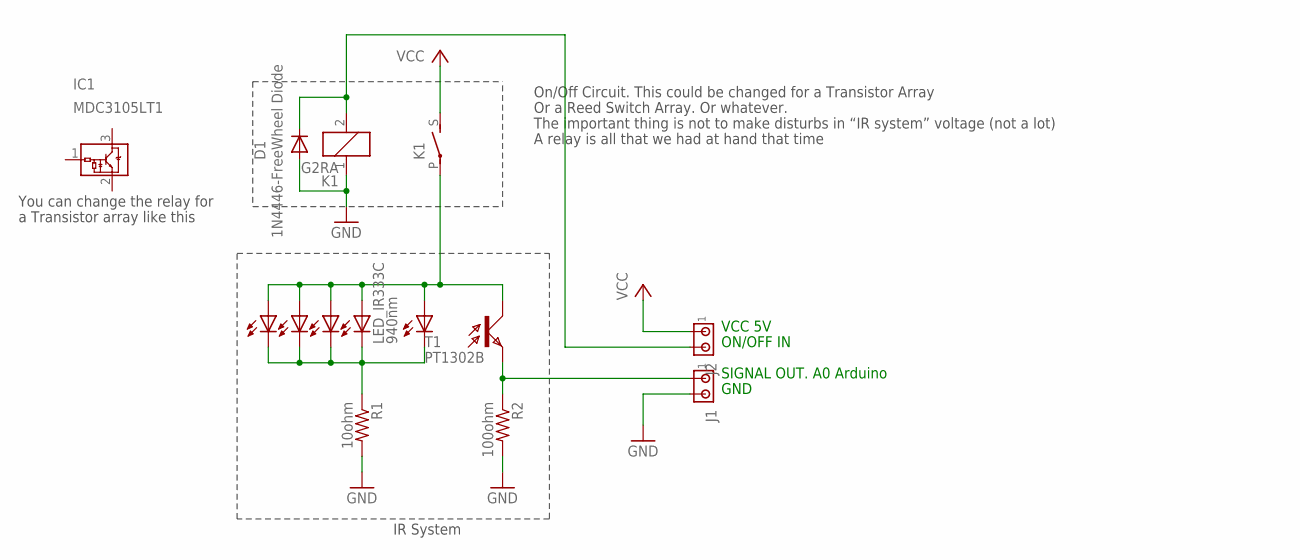
[picture p49: schematic board_IR.sch]

Parts:
D1: 1N4446-FreeWheel Diode; DO35-10
IC1: MDC3105LT1; SOT23
J1, J2: MTA02-156; 1X2MTA
K1: G2RA
LED_IR333C, LED_IR333C1, LED_IR333C2, LED_IR333C3, LED_IR333C4: 940nm; LED5MM
R1: 10ohm; 0204/7
R2: 100ohm; 0204/7
T1: PT1302B; LPT80A

Connections:
GND: D1.A, J1.2, K1.1, R1.2, R2.2
unnamed: LED_IR333C.K (C), LED_IR333C1.K (C), LED_IR333C2.K (C), LED_IR333C3.K (C), LED_IR333C4.K (C), R1.1
unnamed: J1.1, R2.1, T1.E
ON/OFF: D1.C, J2.2, K1.2
SWITCH: K1.P, LED_IR333C.A, LED_IR333C1.A, LED_IR333C2.A, LED_IR333C3.A, LED_IR333C4.A, T1.C
VCC: J2.1, K1.S

Notes on the sheet:
ON/OFF IN
VCC 5V
SIGNAL OUT. A0 Arduino
GND
On/Off Circuit. This could be changed for a Transistor Array
A relay is all that we had at hand that time
Or a Reed Switch Array. Or whatever.
The important thing is not to make disturbs in “IR system” voltage (not a lot)
You can change the relay for
a Transistor array like this
IR System

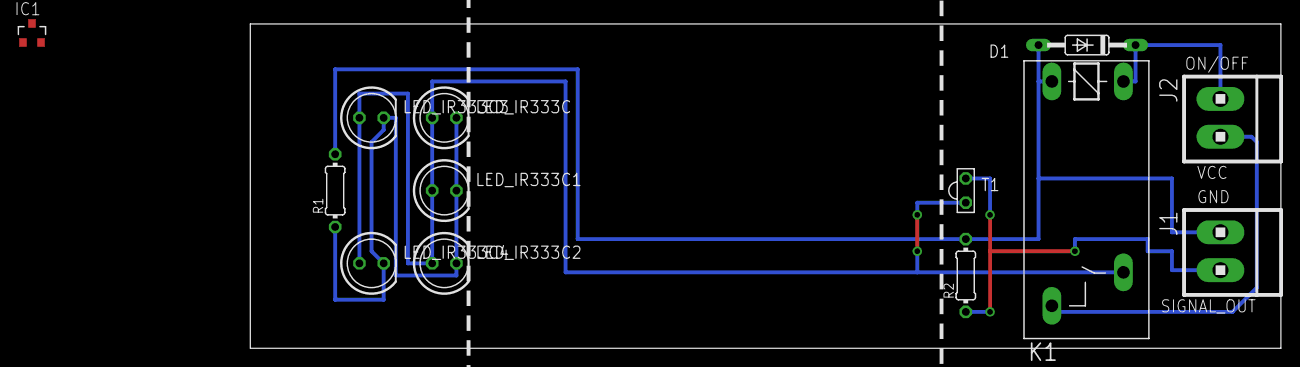
[picture p50: board board_IR.brd from above]

Board: 2 copper layers, 107.9 x 34.0 mm, 13 parts (0 on the bottom side), 6 nets.
