hmojicag/public-glucometro-infrarrojo/SourceV0.3/Eagle-Board-Schematics/shieldArduinoMega/shieldArduinoMega.brd

## EAGLE design SourceV0.3/Eagle-Board-Schematics/shieldArduinoMega/shieldArduinoMega.brd (2019-03-25)

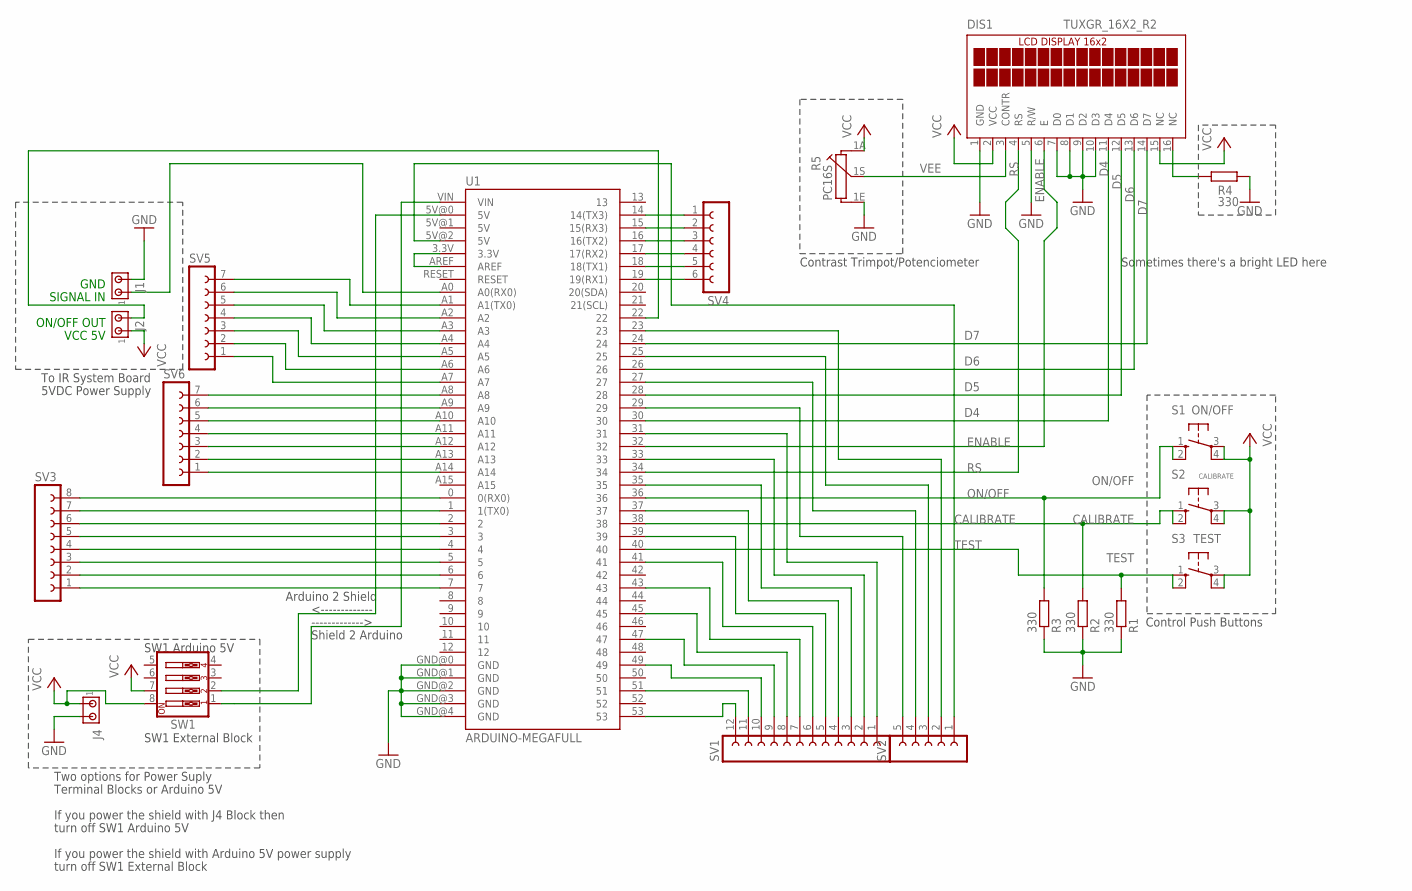
[picture p51: schematic shieldArduinoMega.sch]

Parts:
DIS1: TUXGR_16X2_R2
J1, J2, J4: MTA02-156; 1X2MTA
R1, R2, R3, R4: 330; 0204/7
R5: PC16S
S1: ON/OFF; B3F-10XX
S2: CALIBRATE; B3F-10XX
S3: TEST; B3F-10XX
SV1: FE12-1; FE12
SV2: FE05-1
SV3: FE08-1; FE08
SV4: FE06-1; FE06
SV5, SV6: FE07-1; FE07
SW1: SW_DIP-4; EDG-04
U1: ARDUINO-MEGAFULL; ARDUINO_MEGA

Connections:
3.3: U1.3.3V, U1.AREF
CALIBRATE: R2.2, S2.1 (S), S2.2 (S1), U1.38
D4: DIS1.11 (D4), U1.30
D5: DIS1.12 (D5), U1.28
D6: DIS1.13 (D6), U1.26
D7: DIS1.14 (D7), U1.24
ENABLE: DIS1.6 (E), U1.32
GND: DIS1.1 (GND), DIS1.5 (R/W), DIS1.7 (D0), DIS1.8 (D1), DIS1.9 (D2), DIS1.10 (D3), J1.2, J4.2, R1.1, R2.1, R3.1, R4.2, R5.1E, U1.GND@0 (GND), U1.GND@1 (GND), U1.GND@2 (GND), U1.GND@3 (GND), U1.GND@4 (GND)
IR_ON/OFF: J2.2, U1.22
LED-: DIS1.16 (NC), R4.1
unnamed: SV1.12, U1.53
unnamed: SW1.1, U1.VIN
unnamed: SV1.11, U1.51
unnamed: SW1.2, U1.5V@0 (5V)
unnamed: SV1.10, U1.49
unnamed: SV1.9, U1.47
unnamed: SV1.8, U1.45
unnamed: SV1.7, U1.43
unnamed: SV1.6, U1.41
unnamed: SV1.5, U1.39
unnamed: SV1.4, U1.37
unnamed: SV1.3, U1.35
unnamed: SV1.2, U1.33
unnamed: SV1.1, U1.31
unnamed: SV2.5, U1.29
unnamed: SV2.4, U1.27
unnamed: SV2.3, U1.25
unnamed: SV2.2, U1.23
unnamed: SV2.1, U1.5V@2 (5V)
unnamed: SV3.8, U1.0 (0(RX0))
unnamed: SV3.7, U1.1 (1(TX0))
unnamed: SV3.6, U1.2
unnamed: SV3.5, U1.3
unnamed: SV3.4, U1.4
unnamed: SV3.3, U1.5
unnamed: SV3.2, U1.6
unnamed: SV3.1, U1.7
unnamed: SV4.1, U1.14 (14(TX3))
unnamed: SV4.2, U1.15 (15(RX3))
unnamed: SV4.3, U1.16 (16(TX2))
unnamed: SV4.4, U1.17 (17(RX2))
unnamed: SV4.5, U1.18 (18(TX1))
unnamed: SV4.6, U1.19 (19(RX1))
unnamed: SV5.7, U1.A1 (A1(TX0))
unnamed: SV5.6, U1.A2
unnamed: SV5.5, U1.A3
unnamed: SV5.4, U1.A4
unnamed: SV5.3, U1.A5
unnamed: SV5.2, U1.A6
unnamed: SV5.1, U1.A7
unnamed: SV6.7, U1.A8
unnamed: SV6.6, U1.A9
unnamed: SV6.5, U1.A10
unnamed: SV6.4, U1.A11
unnamed: SV6.3, U1.A12
unnamed: SV6.2, U1.A13
unnamed: SV6.1, U1.A14
ON/OFF: R3.2, S1.1 (S), S1.2 (S1), U1.36
RS: DIS1.4 (RS), U1.34
SIGNAL_IN: J1.1, U1.A0 (A0(RX0))
TEST: R1.2, S3.1 (S), S3.2 (S1), U1.40
VCC: DIS1.2 (VCC), DIS1.15 (NC), J2.1, J4.1, R5.1A, S1.3, S1.4 (P1), S2.3, S2.4 (P1), S3.3, S3.4 (P1), SW1.7, SW1.8
VEE: DIS1.3 (CONTR), R5.1S

Notes on the sheet:
ON/OFF OUT
VCC 5V
SIGNAL IN
GND
To IR System Board
Two options for Power Suply
5VDC Power Supply
Terminal Blocks or Arduino 5V
If you power the shield with J4 Block then
SW1 Arduino 5V
SW1 External Block
turn off SW1 Arduino 5V
If you power the shield with Arduino 5V power supply
turn off SW1 External Block
<-------------
------------->
Arduino 2 Shield
Shield 2 Arduino
Control Push Buttons
Sometimes there's a bright LED here
Contrast Trimpot/Potenciometer

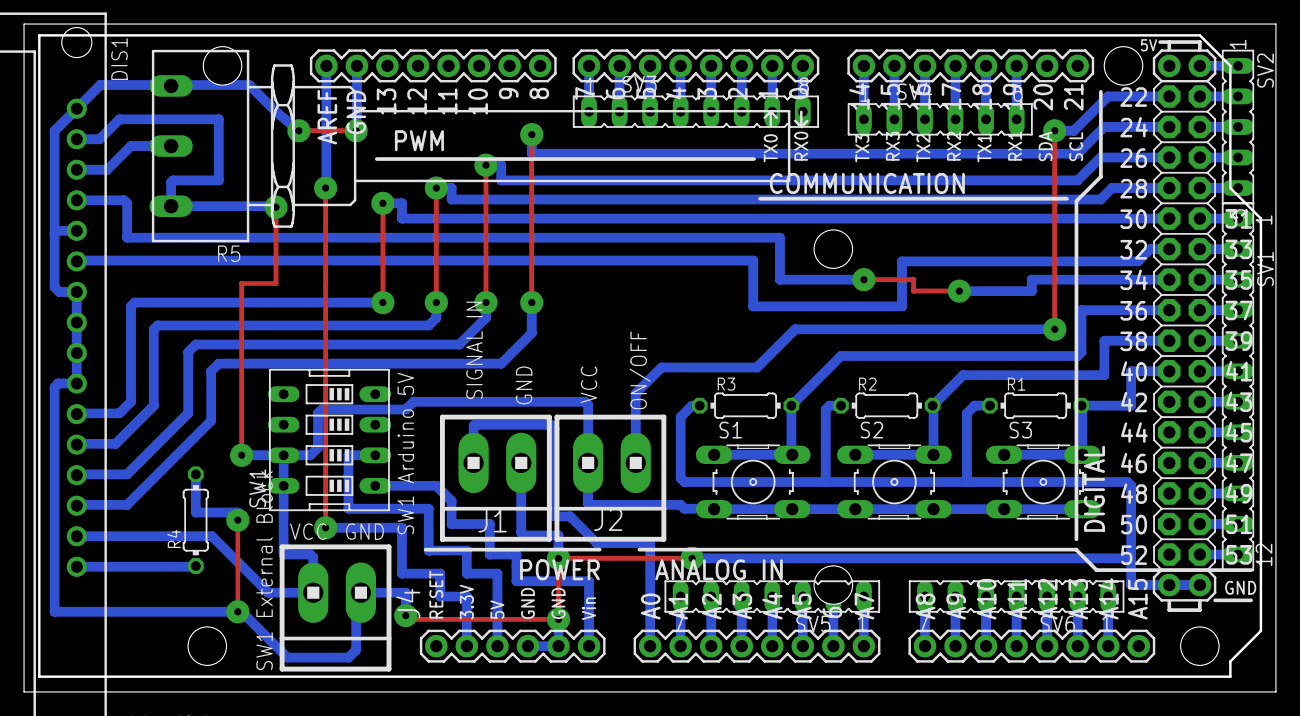
[picture p52: board shieldArduinoMega.brd from above]

Board: 2 copper layers, 104.1 x 55.5 mm, 20 parts (0 on the bottom side), 63 nets.
